mattias7295/parkfordon/testkörning_karta.PNG

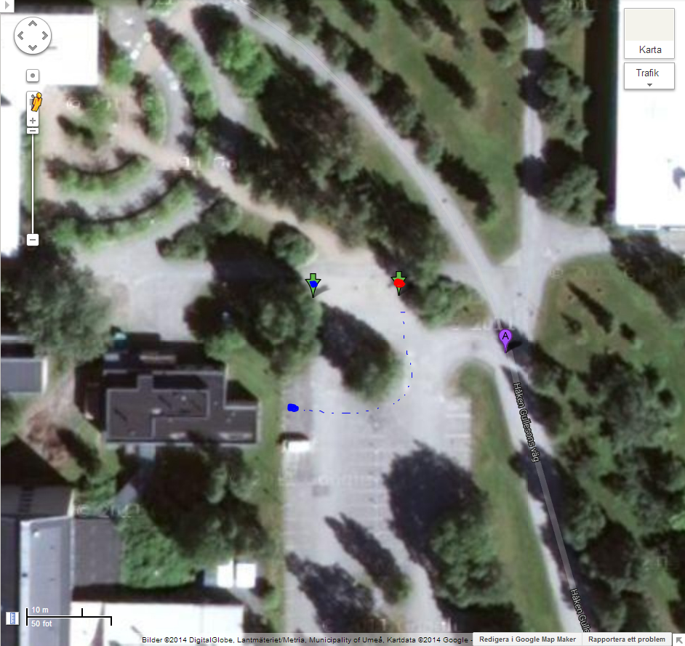
testkörning_karta.PNG
