mattias7295/parkfordon/GPS-fel.PNG

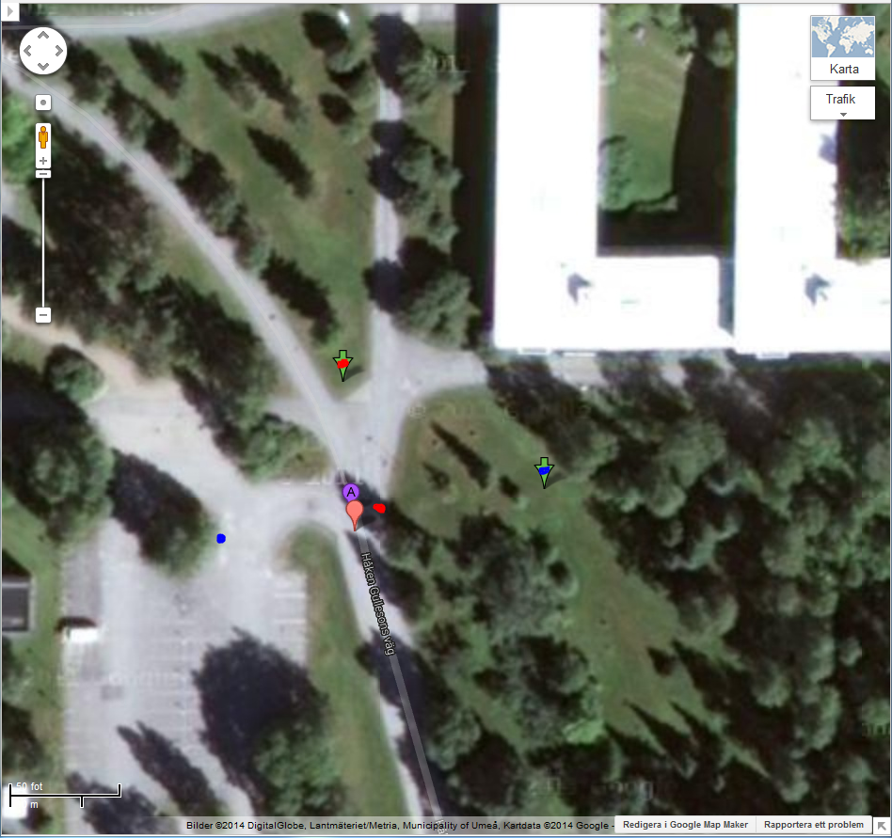
GPS-fel.PNG
