mattias7295/parkfordon/KopplingsSchema Fordon.png

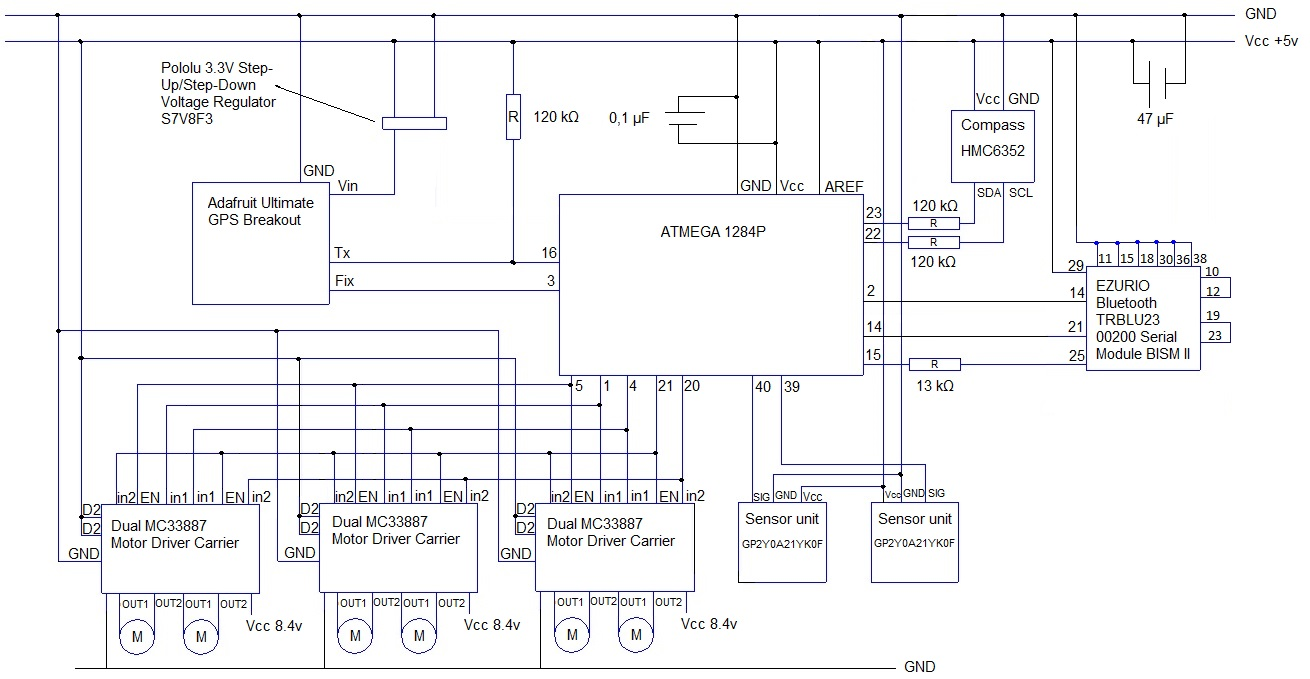
KopplingsSchema Fordon.png
