mattias7295/parkfordon/KopplingsSchema Kontroll.png

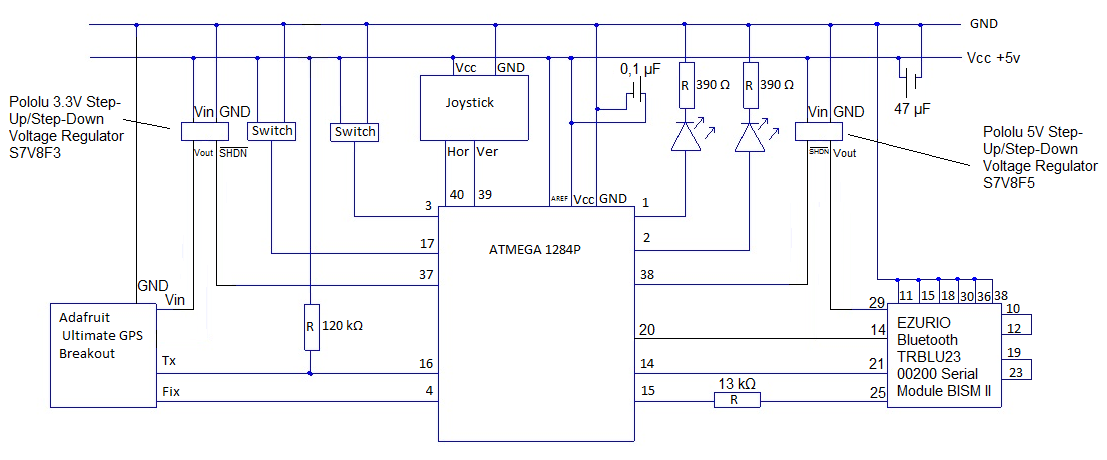
KopplingsSchema Kontroll.png
