mattias7295/parkfordon/Ritning.png

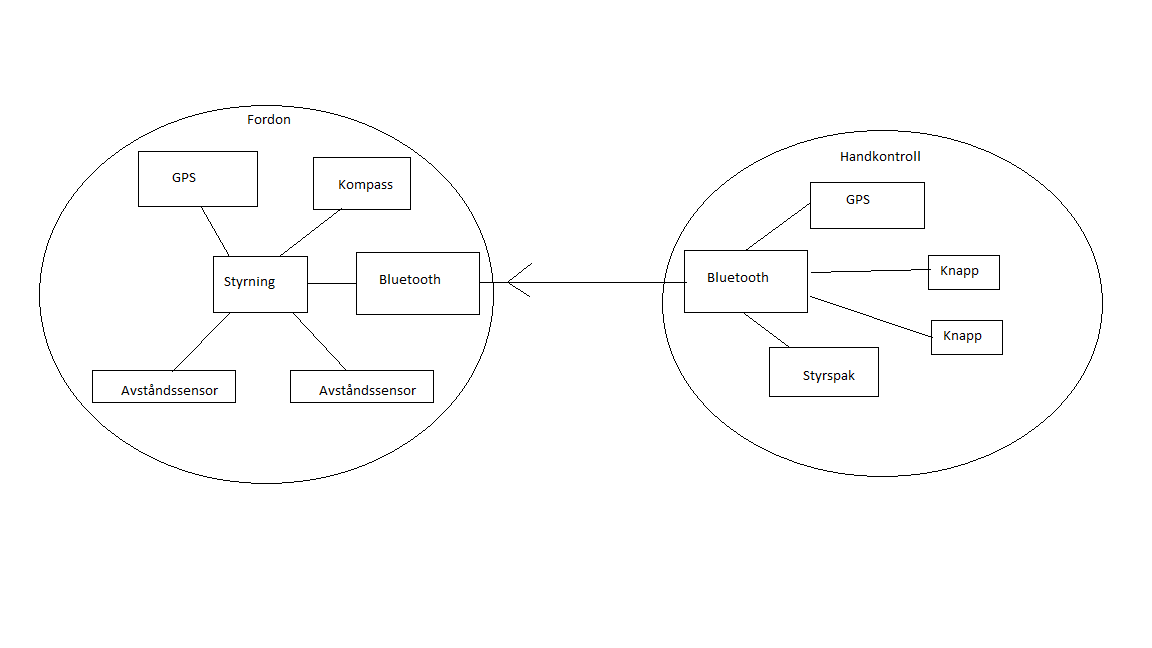
Ritning.png
