mattias7295/parkfordon/tidsplan2.0.PNG

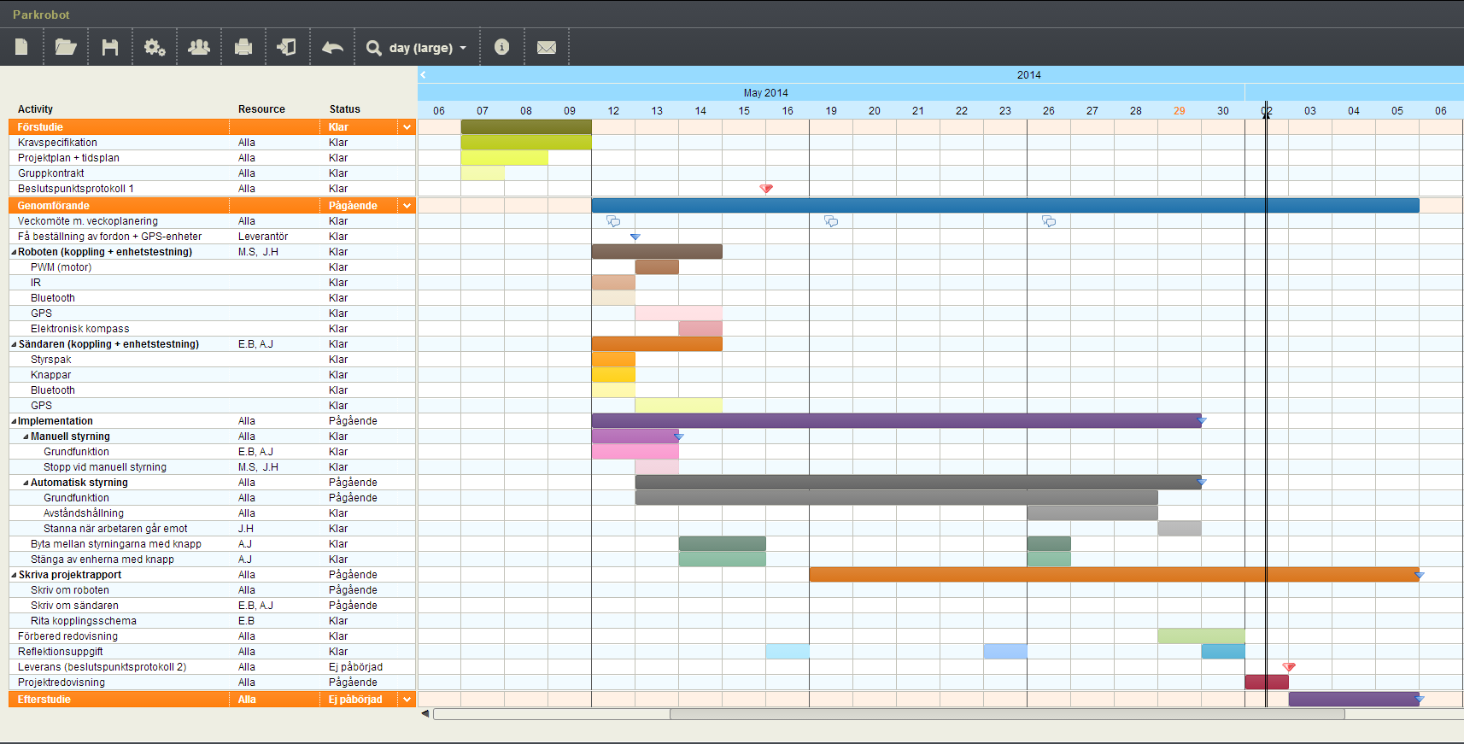
tidsplan2.0.PNG
