mattias7295/parkfordon/(list of files, cad)

Other CAD files:
Litet papper skelett fordon.SLDDRW
SkelettSchema Fordon.SLDDRW
SkellettSchema Kontroll.SLDDRW
