mattias7295/parkfordon/anvandarguide.pdf

# Användarguide

June 3, 2014

## 1 Innan du startar

1. Det första du måste göra innan du kan börja köra är att först koppla in strömmen i fordonet och vänta tills lampan på gps-enheten slutar blinka. Detta betyder att gps-enheten har fått kontakt med tillräckligt många satelliter.

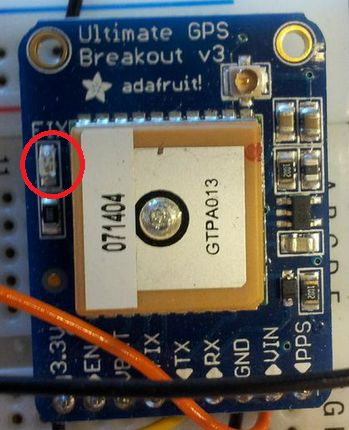
[picture p7: figure]

Figure 1: Lampan som ska sluta blinka

2. Nästa steg är att koppla in strömmen i handkontrollen och även där vänta på att gps-enheten slutar blinka. Kolla även om den gröna lampan på bluetoothen har börjat lysa, detta betyder att de båda bluetoothenheterna har fått kontakt.

## 2 Användning

När du gjort de föregående stegen så kan du börja använda fordonet. De båda LED lamporna på handkontrollen visar i vilket läge du är. Den övre lampan indikerar om du är i strömsparläge, du kan då inte köra fordonet förrän du

1

byter läge på den övre switchen och lampan börjar lysa. Den nedre lampan

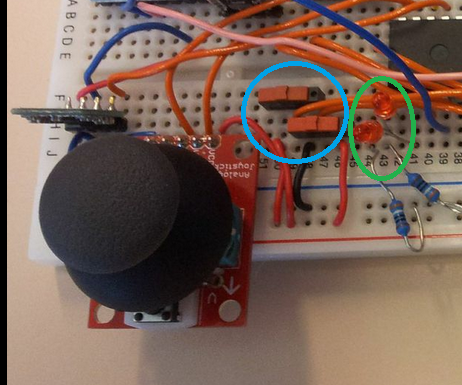
[picture p8: figure]

Figure 2: Switchar och lampor

indikerar om du är i manuell eller automatisk styrning, om lampan är tänd är du i automatisk styrning och fordonet kommer följa efter handkontrollen och stanna på ungefär 2 meters avstånd. Om lampan inte är tänd är du i manuellt läge och kan då köra fordonet med en joystick som sitter på handkontrollen. Om du är i automatiskt läge och vill byta till manuellt kommer först fordonet snurra åt rätt håll innan du kan börja använda den manuella styrningen.

2
