mattias7295/parkfordon/testdata2_140528.txt

LatPerson: 63.820606 
LonPerson: 20.308878 
LatVehicle: 63.820499 
LonVehicle: 20.309502 
Vinkel: 287.500000

LatPerson: 63.820606 
LonPerson: 20.308876 
LatVehicle: 63.820492 
LonVehicle: 20.309484 
Vinkel: 286.299990

LatPerson: 63.820606 
LonPerson: 20.308865 
LatVehicle: 63.820488 
LonVehicle: 20.309490 
Vinkel: 291.200010

LatPerson: 63.820599 
LonPerson: 20.308846 
LatVehicle: 63.820442 
LonVehicle: 20.309467 
Vinkel: 290.500000

LatPerson: 63.820595 
LonPerson: 20.308826 
LatVehicle: 63.820377 
LonVehicle: 20.309490 
Vinkel: 290.500000

LatPerson: 63.820595 
LonPerson: 20.308790 
LatVehicle: 63.820320 
LonVehicle: 20.309488 
Vinkel: 275.700010

currentAngle: 285.610020
wantedAngle: 291.476810
Displacement: 158.523210
diff: -5.866791
absDiff: 5.866791

LatPerson: 63.820591 
LonPerson: 20.308733 
LatVehicle: 63.820290 
LonVehicle: 20.309380 
Vinkel: 291.700010

LatPerson: 63.820591 
LonPerson: 20.308752 
LatVehicle: 63.820259 
LonVehicle: 20.309357 
Vinkel: 294.299990

LatPerson: 63.820587 
LonPerson: 20.308769 
LatVehicle: 63.820313 
LonVehicle: 20.309158 
Vinkel: 313.299990

currentAngle: 310.560000
wantedAngle: 305.217590
Displacement: 144.782410
diff: 5.342407
absDiff: 5.342407

LatPerson: 63.820587 
LonPerson: 20.308786 
LatVehicle: 63.820385 
LonVehicle: 20.308914 
Vinkel: 299.000000

currentAngle: 299.460020
wantedAngle: 327.704040
Displacement: 122.295970
diff: -28.244019
absDiff: 28.244019

currentAngle: 304.880000
wantedAngle: 327.704040
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
Displacement: 162.377700
diff: 31.637695
absDiff: 31.637695

currentAngle: 303.370000
wantedAngle: 287.622310
Displacement: 162.377700
diff: 15.747681
absDiff: 15.747681

currentAngle: 295.419980
wantedAngle: 287.622310
Displacement: 162.377700
diff: 7.797668
absDiff: 7.797668
