mattias7295/parkfordon/testdata3_140528.txt

LatPerson: 63.820641 
LonPerson: 20.308929 
LatVehicle: 63.820705 
LonVehicle: 20.308901 
Vinkel: 351.700010

currentAngle: 350.819980
wantedAngle: 156.194060
Displacement: 293.805940
diff: 194.625920
absDiff: 194.625920

currentAngle: 350.669980
wantedAngle: 156.194060
Displacement: 293.805940
diff: 194.475920
absDiff: 194.475920

currentAngle: 353.190000
wantedAngle: 156.194060
Displacement: 293.805940
diff: 196.995940
absDiff: 196.995940

currentAngle: 358.019990
wantedAngle: 156.194060
Displacement: 293.805940
diff: 201.825930
absDiff: 201.825930

currentAngle: 357.290010
wantedAngle: 156.194060
Displacement: 293.805940
diff: 201.095950
absDiff: 201.095950

currentAngle: 71.939995
wantedAngle: 156.194060
Displacement: 293.805940
diff: -84.254066
absDiff: 84.254066

currentAngle: 3.130000
wantedAngle: 156.194060
Displacement: 293.805940
diff: -153.064060
absDiff: 153.064060

currentAngle: 6.370000
wantedAngle: 156.194060
Displacement: 293.805940
diff: -149.824070
absDiff: 149.824070

currentAngle: 7.880000
wantedAngle: 156.194060
Displacement: 293.805940
diff: -148.314060
absDiff: 148.314060

currentAngle: 17.109999
wantedAngle: 156.194060
Displacement: 293.805940
diff: -139.084060
absDiff: 139.084060

currentAngle: 28.460001
wantedAngle: 156.194060
Displacement: 293.805940
diff: -127.734060
absDiff: 127.734060

currentAngle: 37.720001
wantedAngle: 156.194060
Displacement: 293.805940
diff: -118.474060
absDiff: 118.474060

currentAngle: 41.359997
wantedAngle: 156.194060
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
Displacement: 328.477810
diff: 20.457825
absDiff: 20.457825

currentAngle: 138.590000
wantedAngle: 121.522190
Displacement: 328.477810
diff: 17.067810
absDiff: 17.067810

currentAngle: 128.050000
wantedAngle: 121.522190
Displacement: 328.477810
diff: 6.527817
absDiff: 6.527817
