mattias7295/parkfordon/(commit log)

2014-05-08 lagt till usart och adc till fordon
2014-05-09 skapde nya projekt
    [TcfTransactionLog.csv]
2014-05-09 skrivit in usart och adc
2014-05-09 fungerande adc och usart
2014-05-09 skapade fil för pwm
2014-05-09 skrivit pwm-init och motorer
2014-05-09 la till spi för kompass
2014-05-09 Testing
    Tested jostick and buttons
2014-05-12 button_interrupt files created
2014-05-12 Name change, interrupts added
2014-05-12 twi fix + datablad hbrygga
    [twi.c]
2014-05-12 Interrupts done (but not tested)
2014-05-13 fixing pwm
2014-05-13 interrupt update
2014-05-13 Interrupt klar
2014-05-14 Datablad bluetooth odyl
    [TcfTransactionLog.csv]
2014-05-14 Ingen delay
    [TcfTransactionLog.csv]
2014-05-15 Parser i kontroll
    [TcfTransactionLog.csv]
2014-05-16 Parsning klar
    [TcfTransactionLog.csv]
2014-05-19 skitfel måste fixas i fordon parser
    [GPS_parser.c, GPSparser.c, GPSparser.h, control_pad.c, fordon.c]
2014-05-19 leker lite
    [TcfTransactionLog.csv]
2014-05-23 TESTA KODEN! Fixat så att den hittar rätt lättare bland annat
    [fordon.c]
2014-05-26 försöker fixa byte mellan auto och man
    [control_pad.c, fordon.c, usart.h]
2014-05-26 Test uart interrupt
2014-05-26 Testa ta bort TIMERN och kör och se
2014-05-26 Hittat rätta namnet på interrupt-vectorn.
    DET KAN FUNKA NU
2014-05-27 KopplingsSchema Kontroll klart
    [SkellettSchema Kontroll.SLDDRW]
2014-05-27 Fixat on/off samt man/auto
    [GPS_parser.c, GPSparser.c, control_pad.c, control_pad.h, fordon.c, fordon.h, usart.c]
2014-05-29 Alla kopplingsScheman
    [Litet papper skelett fordon.SLDDRW, SkelettSchema Fordon.SLDDRW]
